Diabltica/AudioInterface/AudioInterface.kicad_pcb

## KiCad design AudioInterface.kicad_pcb (2024-12-24)

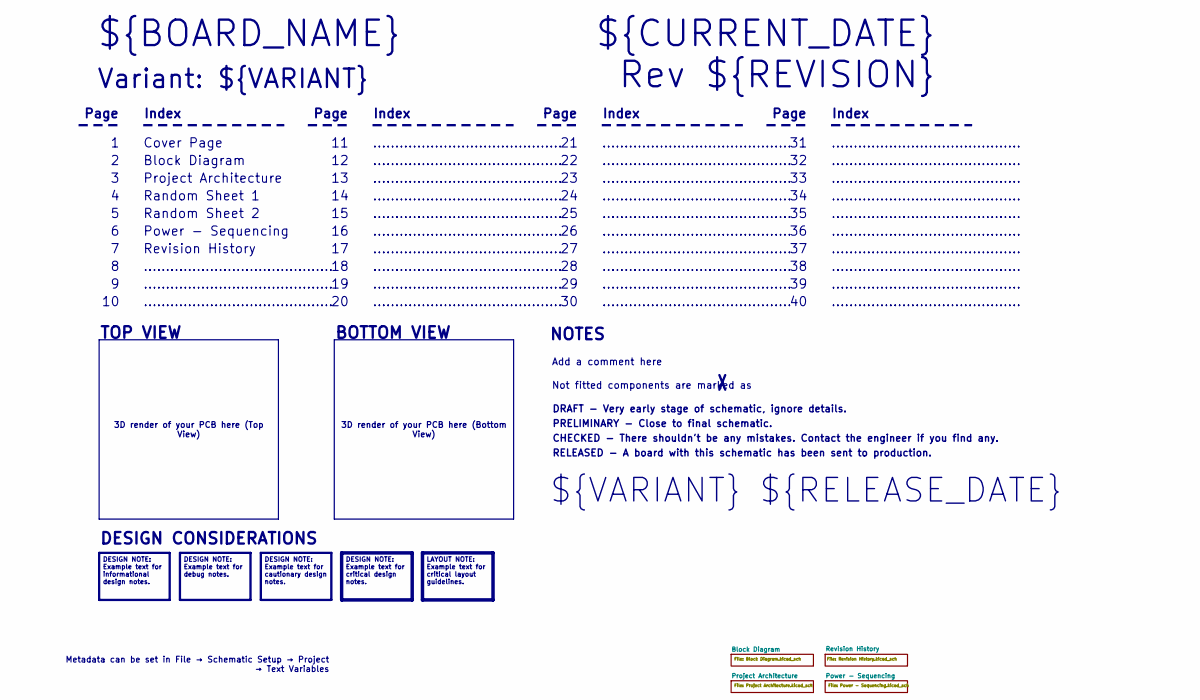
[picture p1: schematic AudioInterface.kicad_sch, Cover Page]

Notes on the sheet:
3D render of your PCB here (Bottom View)
3D render of your PCB here (Top View)
Metadata can be set in File → Schematic Setup → Project → Text Variables
DESIGN NOTE: Example text for informational design notes.
LAYOUT NOTE: Example text for critical layout guidelines.
DESIGN NOTE: Example text for cautionary design notes.
DESIGN NOTE: Example text for debug notes.
DESIGN NOTE: Example text for critical design notes.
BOTTOM VIEW
...........................................
RELEASED - A board with this schematic has been sent to production.
Page
TOP VIEW
Not fitted components are marked as
Index
PRELIMINARY - Close to final schematic.
${VARIANT} ${RELEASE_DATE}
Random Sheet 1
${CURRENT_DATE}
Variant: ${VARIANT}
Rev ${REVISION}
Random Sheet 2
${BOARD_NAME}
DRAFT - Very early stage of schematic, ignore details.
Power - Sequencing
Block Diagram
Add a comment here
Cover Page
NOTES
Project Architecture
CHECKED - There shouldn't be any mistakes. Contact the engineer if you find any.
DESIGN CONSIDERATIONS
Revision History

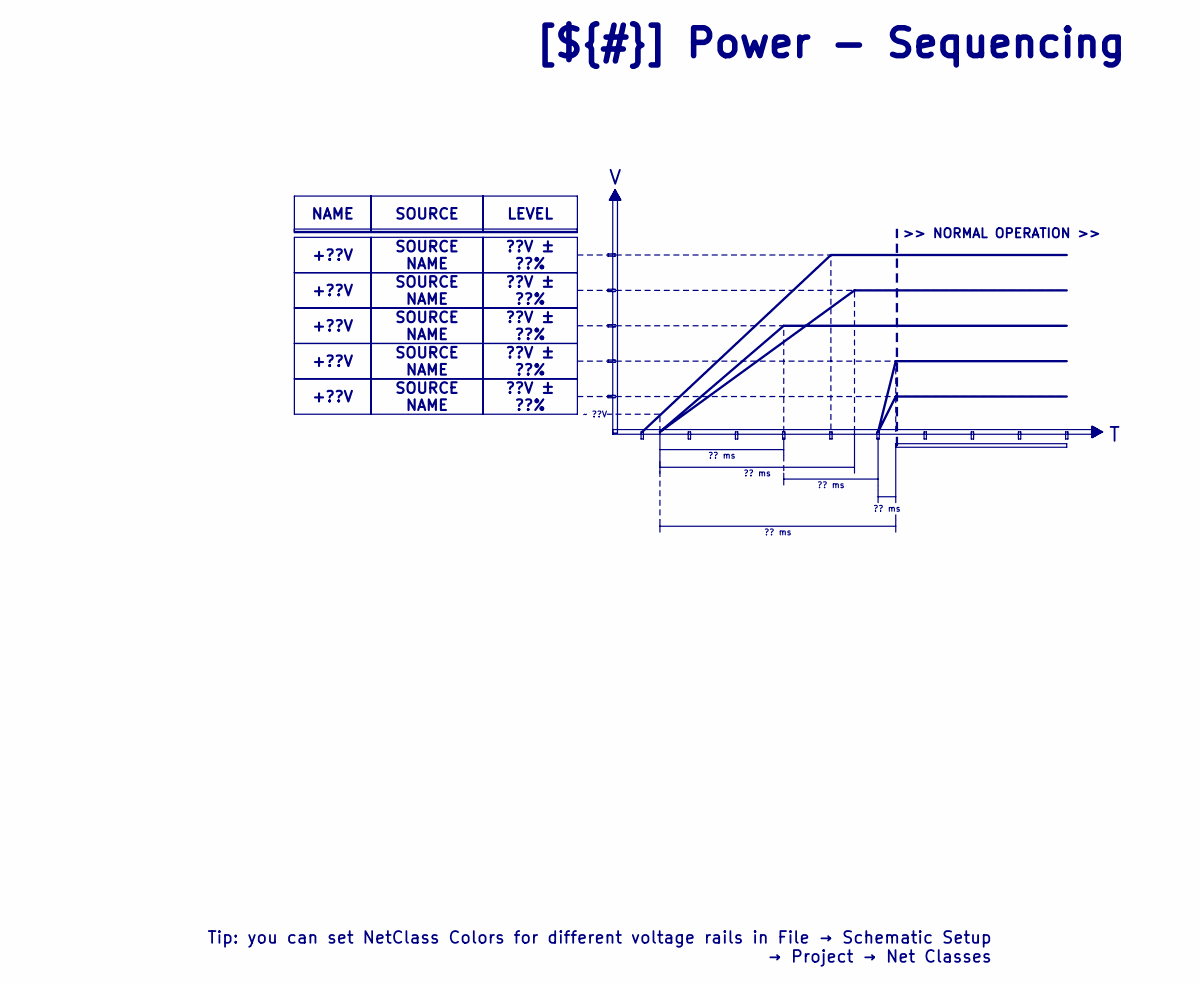
[picture p2: schematic Power - Sequencing.kicad_sch]

Notes on the sheet:
LEVEL
+??V
SOURCE NAME
?? ms
??V ± ??%
[${#}] ${TITLE}
~ ??V
NAME
SOURCE
Tip: you can set NetClass Colors for different voltage rails in File → Schematic Setup → Project → Net Classes
>> NORMAL OPERATION >>

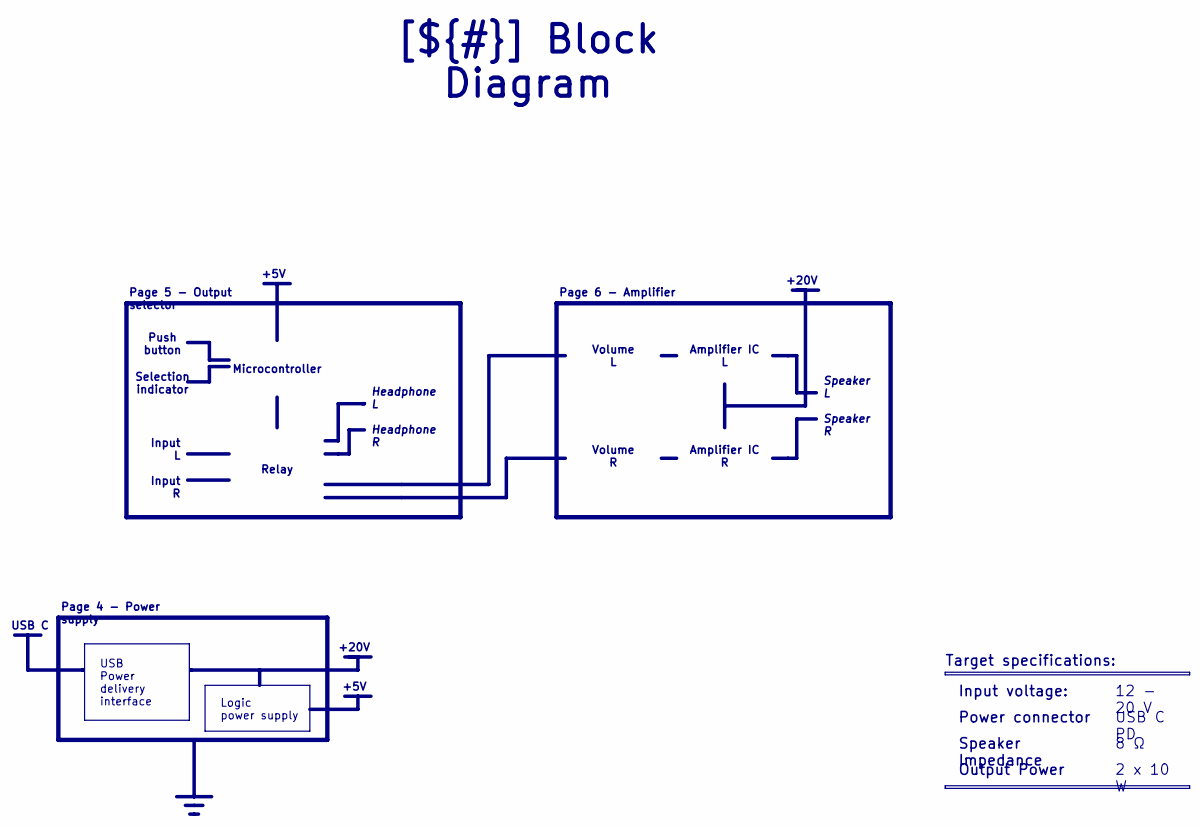
[picture p3: schematic Block Diagram.kicad_sch]

Notes on the sheet:
Page 5 - Output selector
Speaker Impedance
Power connector
Logic power supply
Input voltage:
2 x 10 W
USB C PD
Amplifier IC L
Volume L
Headphone L Headphone R
Microcontroller
[${#}] ${TITLE}
Page 4 - Power supply
Target specifications:
Selection indicator
8 Ω
Page 6 - Amplifier
12 - 20 V
Push button
Amplifier IC R
Relay
Input L Input R
Output Power
USB Power delivery interface
Volume R
Speaker L Speaker R
+20V
+5V
USB C

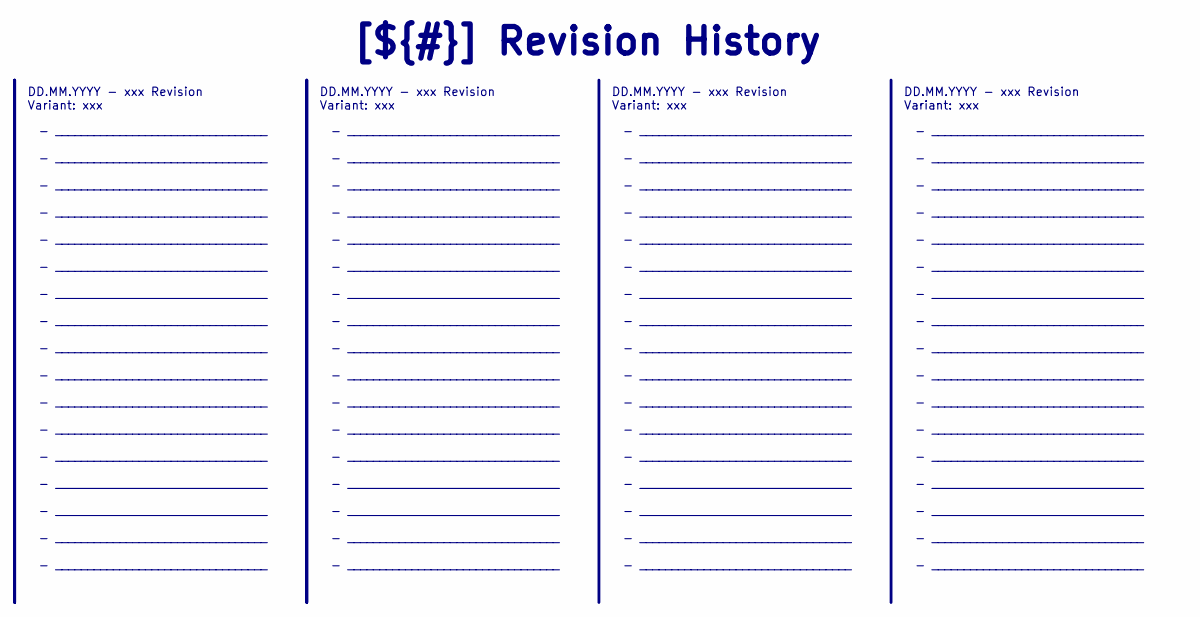
[picture p4: schematic Revision History.kicad_sch]

Notes on the sheet:
- _________________________________ - _________________________________ - _________________________________ - _________________________________ - _________________________________ - _________________________________ - _________________________________ - _________________________________ - _________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
DD.MM.YYYY - xxx Revision Variant: xxx
[${#}] ${TITLE}

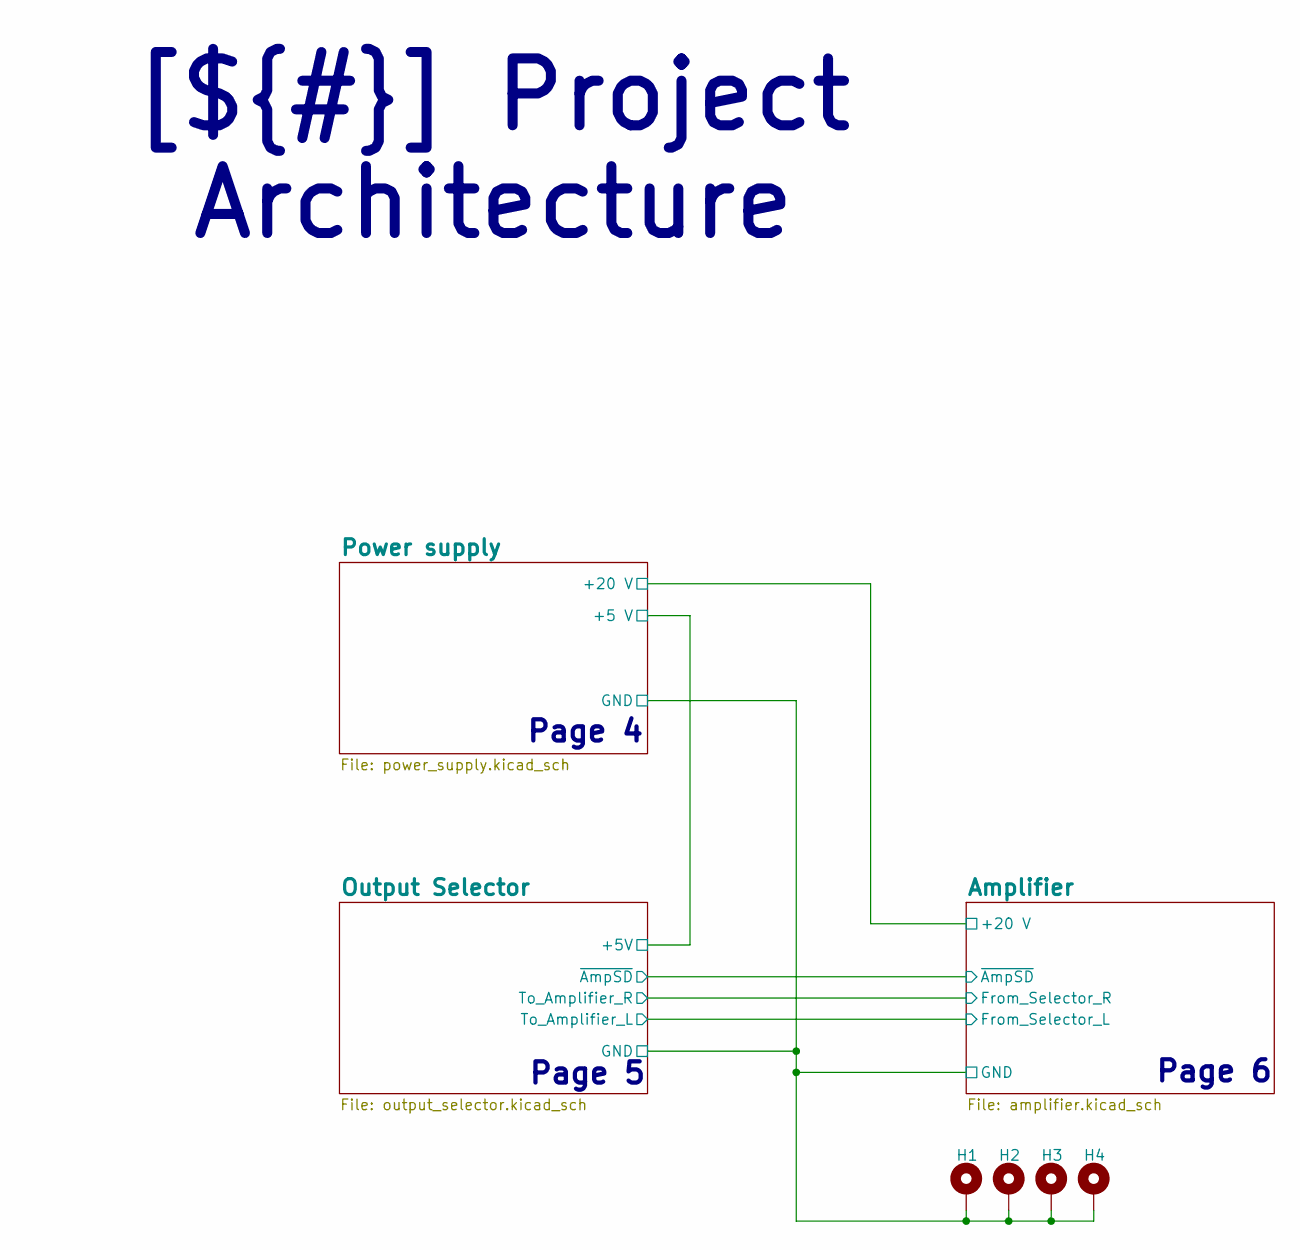
[picture p5: schematic Project Architecture.kicad_sch]

Parts:
H1, H2, H3, H4: MountingHole_Pad; MountingHole_3.2mm_M3_Pad_Via

Connections:
GND: H1.1, H2.1, H3.1, H4.1; also elsewhere on the board

Notes on the sheet:
[${#}] ${TITLE}
Page 6
Page 5
Page 4

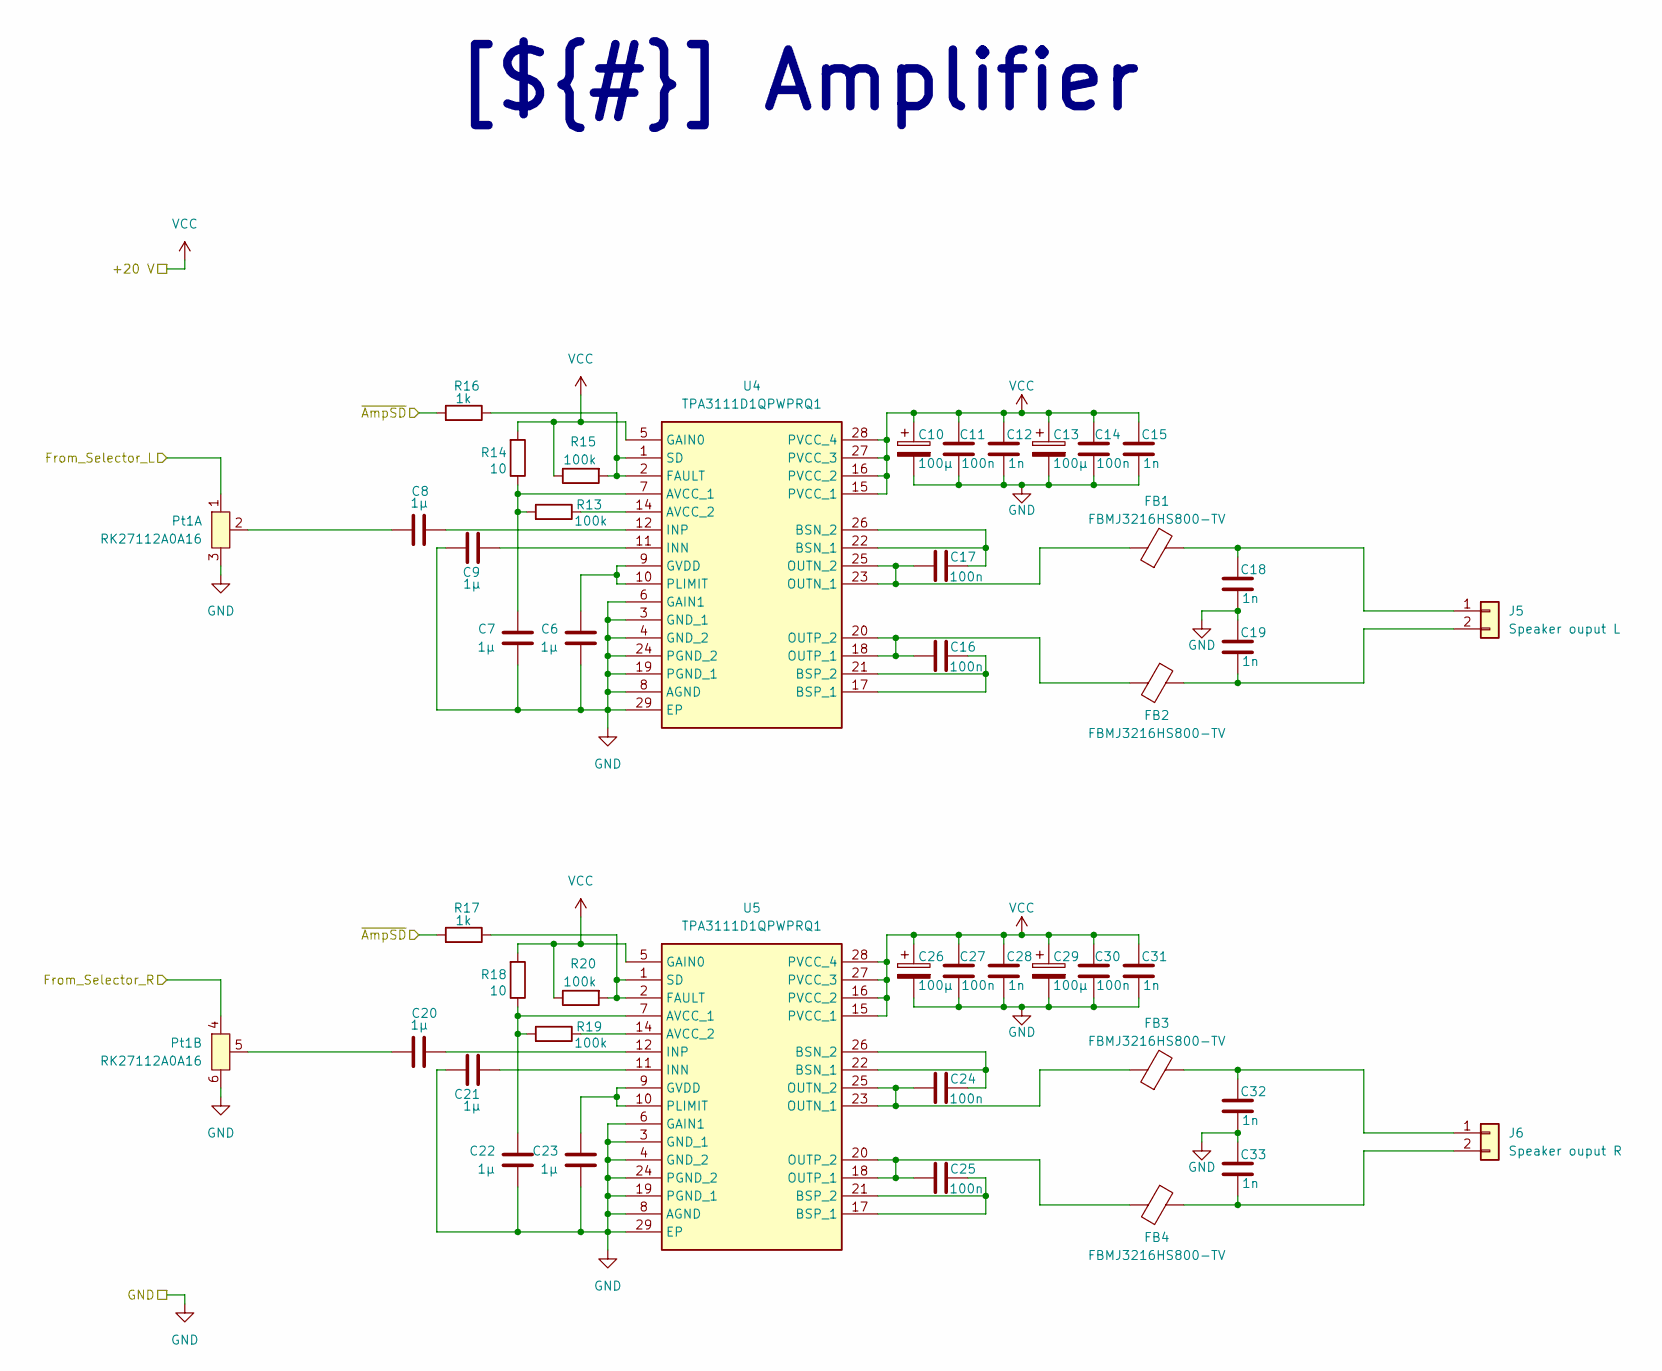
[picture p6: schematic amplifier.kicad_sch]

Parts:
C6, C7, C8, C9, C20, C21, C22, C23: 1µ; C_0402_1005Metric; LCSC Part C1518208
C10, C13, C26, C29: 100µ; CP_Elec_6.3x7.7; LCSC Part C178585
C11, C14, C16, C17, C24, C25, C27, C30: 100n; C_0402_1005Metric; LCSC Part C77020
C12, C15, C18, C19, C28, C31, C32, C33: 1n; C_0402_1005Metric; LCSC Part C77018
FB1, FB2, FB3, FB4: FBMJ3216HS800-TV; L_1206_3216Metric; LCSC C2661525
J5: Speaker ouput L; PinHeader_1x02_P2.54mm_Vertical
J6: Speaker ouput R; PinHeader_1x02_P2.54mm_Vertical
Pt1: RK27112A0A16; RES-ADJ-TH_RK27112A0A16; LCSC Part C470508
R13, R15, R19, R20: 100k; R_0402_1005Metric; LCSC Part C427253
R14, R18: 10; R_0402_1005Metric; LCSC Part C854481
R16, R17: 1k; R_0402_1005Metric; LCSC Part C427241
U4, U5: TPA3111D1QPWPRQ1; SOP65P640X120-29N; Mouser Part Number 595-TPA3111D1QPWPRQ1

Connections:
/Project Architecture/Amplifier/From_Selector_L: Pt1.1; also elsewhere on the board
/Project Architecture/Amplifier/From_Selector_R: Pt1.4; also elsewhere on the board
/Project Architecture/Amplifier/~AmpSD: R16.2, R17.2; also elsewhere on the board
GND: C6.1, C7.1, C9.2, C10.2, C11.1, C12.1, C13.2, C14.1, C15.1, C18.1, C19.2, C21.2, C22.1, C23.1, C26.2, C27.1, C28.1, C29.2, C30.1, C31.1, C32.1, C33.2, Pt1.3, Pt1.6, U4.3 (GND_1), U4.4 (GND_2), U4.6 (GAIN1), U4.8 (AGND), U4.19 (PGND_1), U4.24 (PGND_2), U4.29 (EP), U5.3 (GND_1), U5.4 (GND_2), U5.6 (GAIN1), U5.8 (AGND), U5.19 (PGND_1), U5.24 (PGND_2), U5.29 (EP); also elsewhere on the board
unnamed: C8.1, Pt1.2
unnamed: C20.1, Pt1.5
unnamed: C18.2, FB1.2, J5.1
unnamed: C19.1, FB2.1, J5.2
unnamed: C32.2, FB3.2, J6.1
unnamed: C33.1, FB4.1, J6.2
unnamed: C7.2, R13.2, R14.1, U4.7 (AVCC_1)
unnamed: R13.1, U4.14 (AVCC_2)
unnamed: C17.1, U4.22 (BSN_1), U4.26 (BSN_2)
unnamed: C16.1, U4.17 (BSP_1), U4.21 (BSP_2)
unnamed: R15.2, R16.1, U4.1 (SD), U4.2 (FAULT)
unnamed: C6.2, U4.9 (GVDD), U4.10 (PLIMIT)
unnamed: C9.1, U4.11 (INN)
unnamed: C8.2, U4.12 (INP)
unnamed: C17.2, FB1.1, U4.23 (OUTN_1), U4.25 (OUTN_2)
unnamed: C16.2, FB2.2, U4.18 (OUTP_1), U4.20 (OUTP_2)
unnamed: C22.2, R18.1, R19.2, U5.7 (AVCC_1)
unnamed: R19.1, U5.14 (AVCC_2)
unnamed: C24.1, U5.22 (BSN_1), U5.26 (BSN_2)
unnamed: C25.1, U5.17 (BSP_1), U5.21 (BSP_2)
unnamed: R17.1, R20.2, U5.1 (SD), U5.2 (FAULT)
unnamed: C23.2, U5.9 (GVDD), U5.10 (PLIMIT)
unnamed: C21.1, U5.11 (INN)
unnamed: C20.2, U5.12 (INP)
unnamed: C24.2, FB3.1, U5.23 (OUTN_1), U5.25 (OUTN_2)
unnamed: C25.2, FB4.2, U5.18 (OUTP_1), U5.20 (OUTP_2)
VCC: C10.1, C11.2, C12.2, C13.1, C14.2, C15.2, C26.1, C27.2, C28.2, C29.1, C30.2, C31.2, R14.2, R15.1, R18.2, R20.1, U4.5 (GAIN0), U4.15 (PVCC_1), U4.16 (PVCC_2), U4.27 (PVCC_3), U4.28 (PVCC_4), U5.5 (GAIN0), U5.15 (PVCC_1), U5.16 (PVCC_2), U5.27 (PVCC_3), U5.28 (PVCC_4); also elsewhere on the board

Notes on the sheet:
[${#}] ${TITLE}

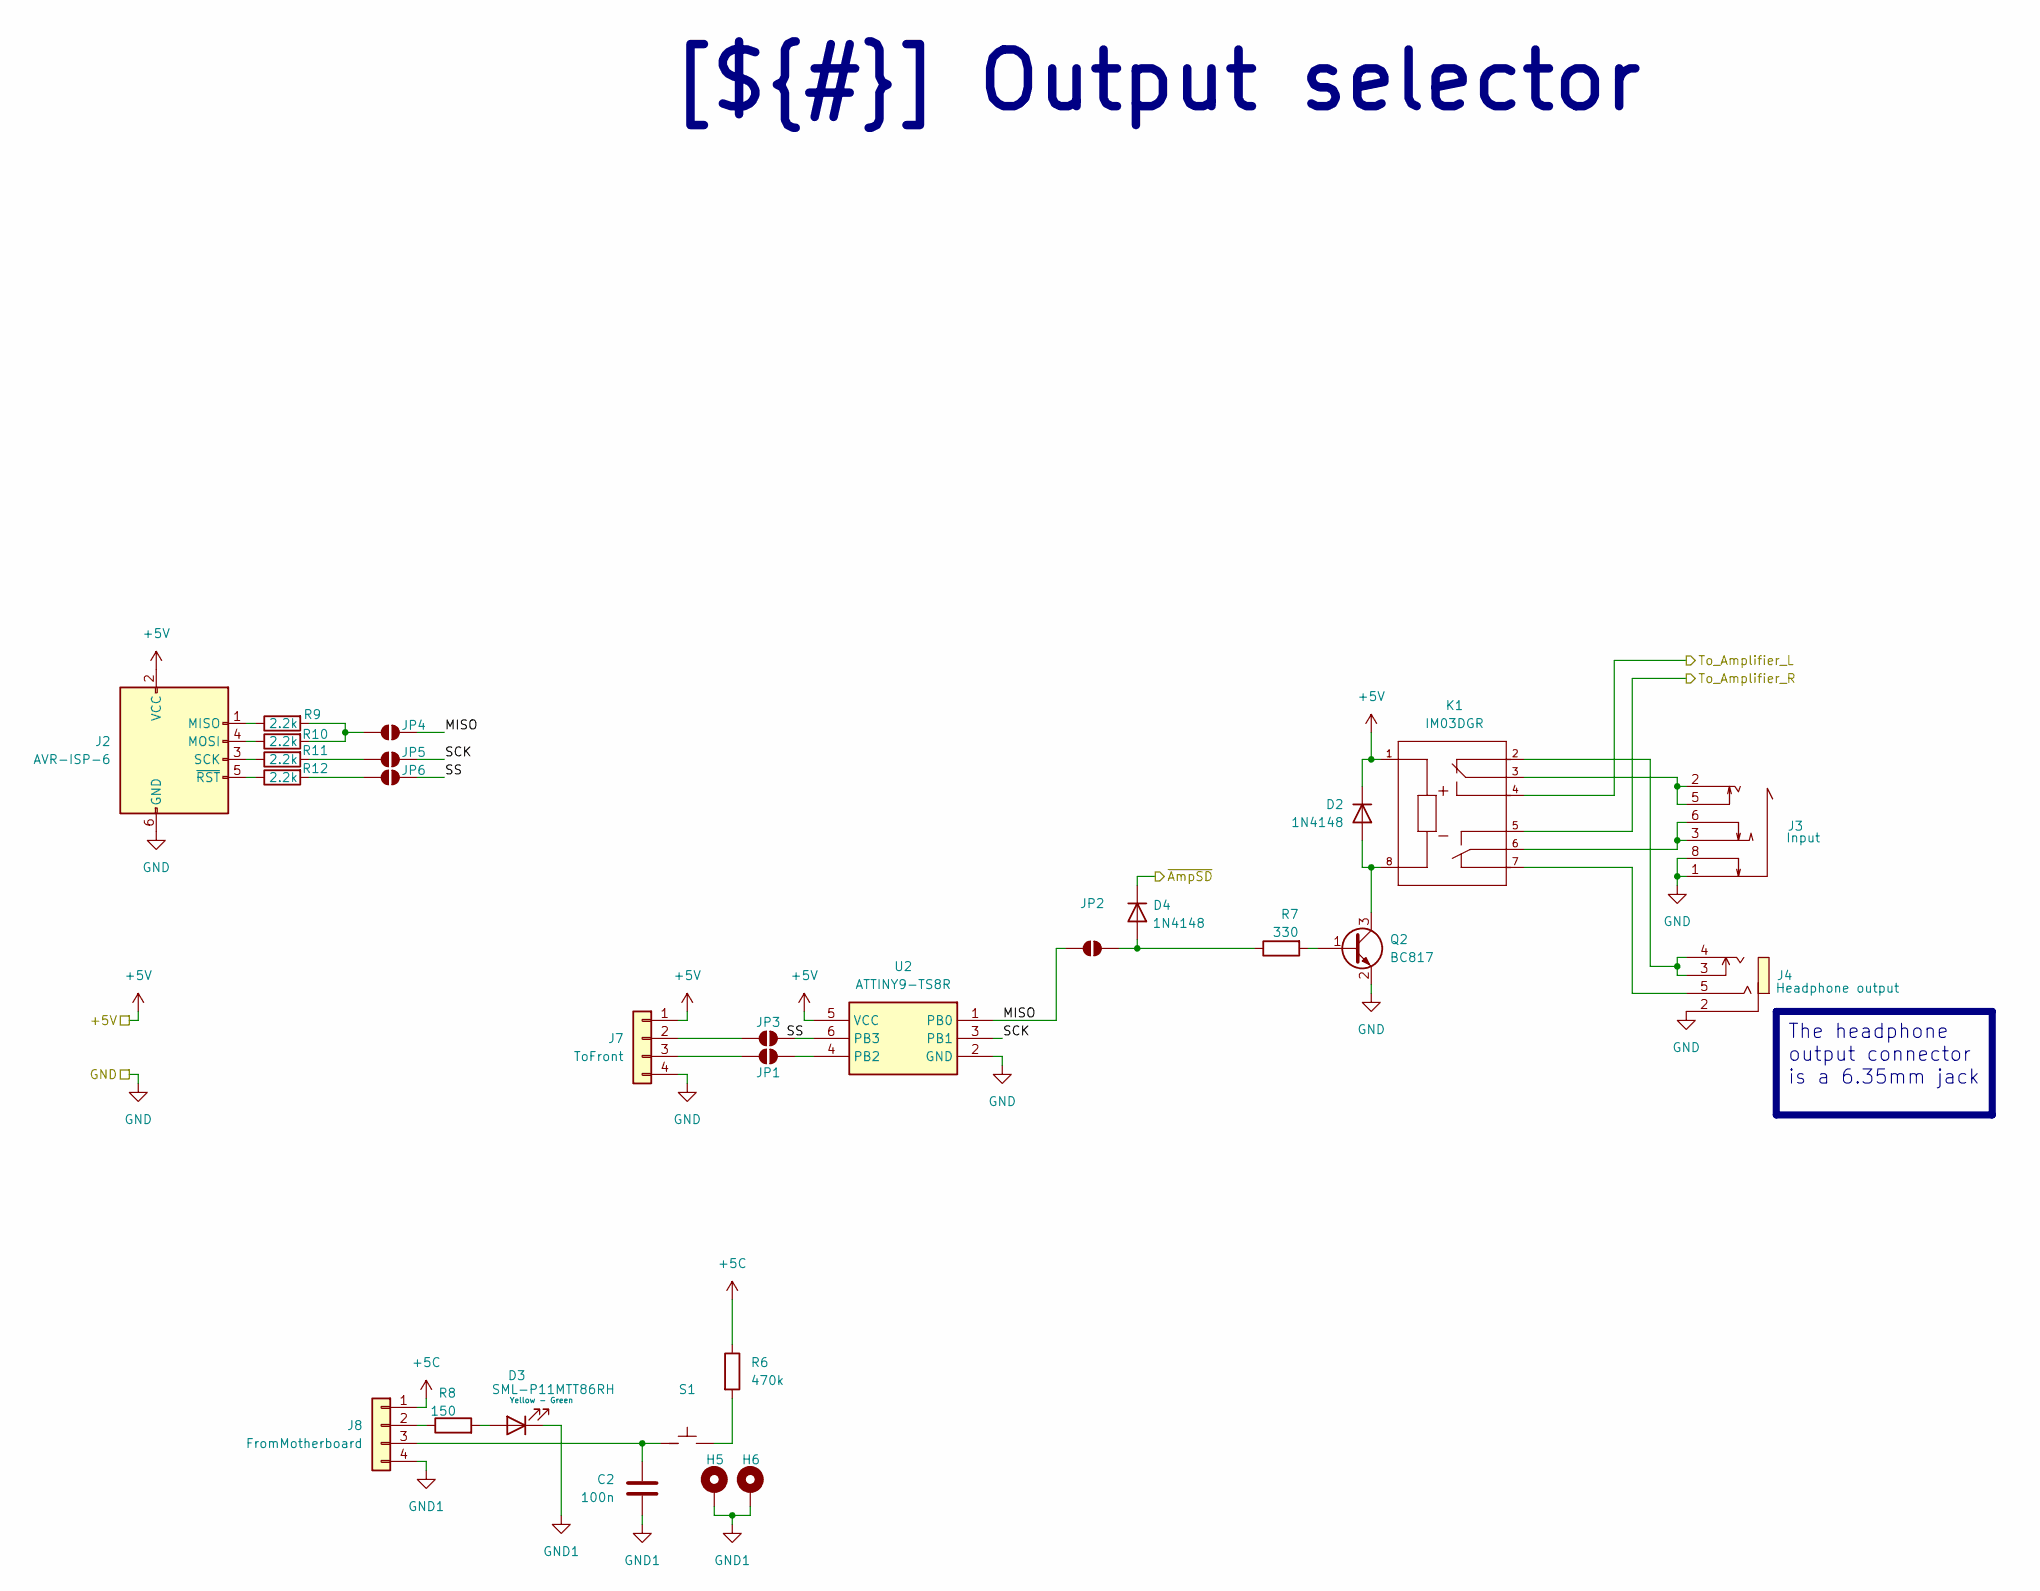
[picture p7: schematic output_selector.kicad_sch, Output selector]

Parts:
C2: 100n; C_0402_1005Metric; LCSC Part C77020
D2, D4: 1N4148; D_SOD-123; LCSC Part C5805632
D3: SML-P11MTT86RH; LED_0402_1005Metric; LCSC part C2898986
H5, H6: MountingHole_Pad; MountingHole_3.2mm_M3_Pad_Via
J2: AVR-ISP-6; PinSocket_2x03_P2.54mm_Vertical
J3: PJ-393-8P; AUDIO-TH_PJ-393-8A; LCSC Part C5155561
J4: PJ-603; AUDIO-TH_PJ-603; LCSC Part C309272
J7: ToFront; PinHeader_1x04_P2.54mm_Vertical
J8: FromMotherboard; PinHeader_1x04_P2.54mm_Vertical
JP1, JP2, JP3, JP4, JP5, JP6: SolderJumper_2_Open; SolderJumper-2_P1.3mm_Open_TrianglePad1.0x1.5mm
K1: IM03DGR; RELAY_IM03DGR; LCSC Part C5439567
Q2: BC817; SOT-23; LCSC Part C52801
R6: 470k; R_0402_1005Metric; LCSC Part C427256
R7: 330; R_0402_1005Metric; LCSC Part C427206
R8: 150; R_0402_1005Metric; LCSC Part C413067
R9, R10, R11, R12: 2.2k; R_0402_1005Metric; LCSC Part C427211
S1: PG151101S11; Kailh_socket_MX; PARTREV A; LCSC Part C41430893
U2: ATTINY9-TS8R; SOT95P270X145-6N; Mouser Part Number 556-ATTINY9-TS8R

Connections:
+5C: J8.1, R6.1
+5V: D2.1 (K), J2.2 (VCC), J7.1, K1.1, U2.5 (VCC); also elsewhere on the board
/Project Architecture/Amplifier/From_Selector_L: K1.4; also elsewhere on the board
/Project Architecture/Amplifier/From_Selector_R: K1.5; also elsewhere on the board
/Project Architecture/Amplifier/~AmpSD: D4.1 (K); also elsewhere on the board
/Project Architecture/Output Selector/MISO: JP2.1 (A), JP4.2 (B), U2.1 (PB0)
/Project Architecture/Output Selector/SCK: JP5.2 (B), U2.3 (PB1)
/Project Architecture/Output Selector/SS: JP3.1 (A), JP6.2 (B), U2.6 (PB3)
GND: J2.6 (GND), J3.1, J3.8, J4.2, J7.4, Q2.2 (E), U2.2 (GND); also elsewhere on the board
GND1: C2.1, D3.1 (K), H5.1, H6.1, J8.4
unnamed: D2.2 (A), K1.8, Q2.3 (C)
unnamed: D3.2 (A), R8.2
unnamed: D4.2 (A), JP2.2 (B), R7.1
unnamed: J2.1 (MISO), R9.1
unnamed: J2.4 (MOSI), R10.1
unnamed: J2.3 (SCK), R11.1
unnamed: J2.5 (~RST), R12.1
unnamed: J3.2, J3.5, K1.3
unnamed: J3.3, J3.6, K1.6
unnamed: J4.3, J4.4, K1.2
unnamed: J4.5, K1.7
unnamed: J7.2, JP3.2 (B)
unnamed: J7.3, JP1.1 (A)
unnamed: J8.2, R8.1
unnamed: C2.2, J8.3, S1.2
unnamed: JP1.2 (B), U2.4 (PB2)
unnamed: JP4.1 (A), R9.2, R10.2
unnamed: JP5.1 (A), R11.2
unnamed: JP6.1 (A), R12.2
unnamed: Q2.1 (B), R7.2
unnamed: R6.2, S1.1

Notes on the sheet:
[${#}] ${TITLE}
The headphone output connector is a 6.35mm jack

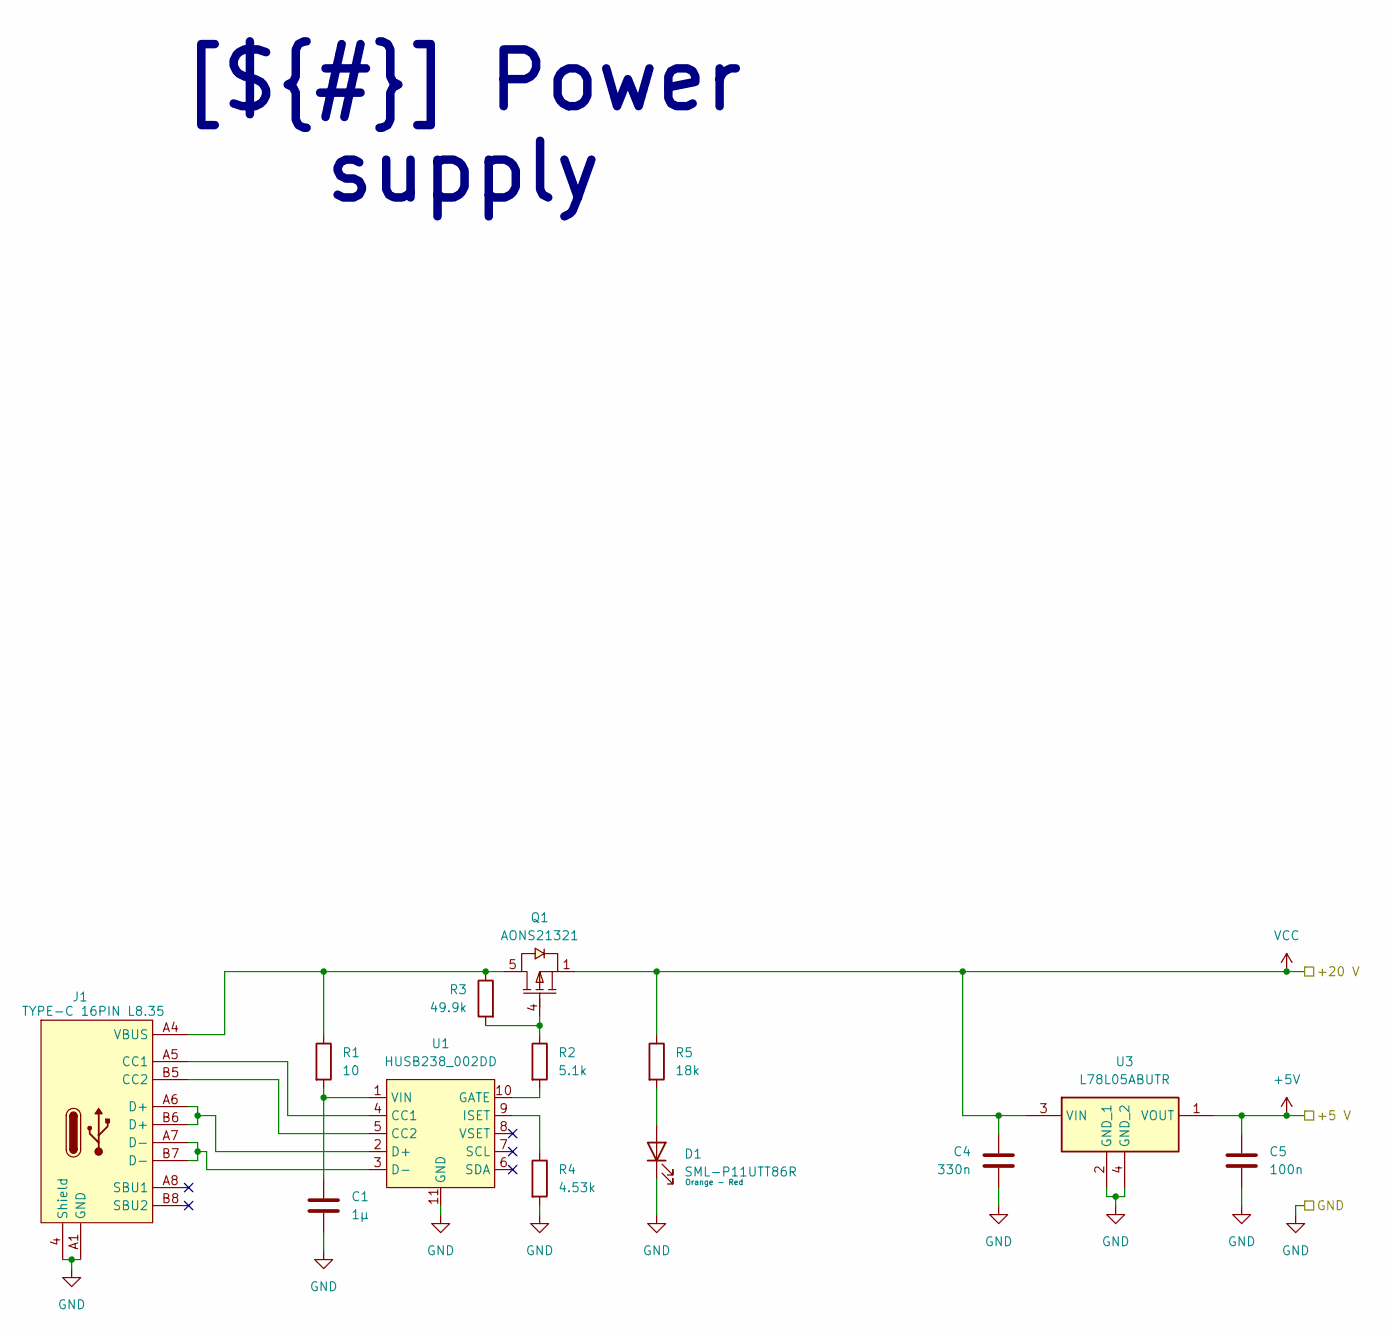
[picture p8: schematic power_supply.kicad_sch, Power supply]

Parts:
C1: 1µ; C_0402_1005Metric; LCSC Part C1518208
C4: 330n; C_0402_1005Metric; LCSC Part C16193239
C5: 100n; C_0402_1005Metric; LCSC Part C77020
D1: SML-P11UTT86R; LED_0402_1005Metric; LCSC part C510300
J1: TYPE-C 16PIN L8.35; TYPE-C-SMD_20009-UCAF001-X; LCSC Part C5379909
Q1: AONS21321; DFN-8_L6.0-W5.0-P1.27-LS6.2-BL; LCSC Part C5143571
R1: 10; R_0402_1005Metric; LCSC Part C854481
R2: 5.1k; R_0603_1608Metric; LCSC Part C413696
R3: 49.9k; R_0402_1005Metric; LCSC Part C409918
R4: 4.53k; R_0402_1005Metric; LCSC Part C416543
R5: 18k; R_0402_1005Metric; LCSC Part C413008
U1: HUSB238_002DD; DFN-10_L3.0-W3.0-P0.50-BL-EP2.5; LCSC Part C7471904
U3: L78L05ABUTR; Mouser Part Number 511-L78L05ABU

Connections:
+5V: C5.2, U3.1 (VOUT); also elsewhere on the board
GND: C1.1, C4.1, C5.1, D1.1 (K), J1.4 (Shield), J1.A1 (GND), R4.2, U1.11 (GND), U3.2 (GND_1), U3.4 (GND_2); also elsewhere on the board
unnamed: D1.2 (A), R5.2
unnamed: J1.A5 (CC1), U1.4 (CC1)
unnamed: J1.B5 (CC2), U1.5 (CC2)
unnamed: J1.A4 (VBUS), Q1.5 (D), R1.1, R3.1
unnamed: Q1.4 (G), R2.1, R3.2
unnamed: J1.A6 (D+), J1.B6 (D+), U1.2 (D+)
unnamed: J1.A7 (D-), J1.B7 (D-), U1.3 (D-)
unnamed: R2.2, U1.10 (GATE)
unnamed: R4.1, U1.9 (ISET)
unnamed: C1.2, R1.2, U1.1 (VIN)
VCC: C4.2, Q1.1 (S), R5.1, U3.3 (VIN); also elsewhere on the board

Notes on the sheet:
[${#}] ${TITLE}

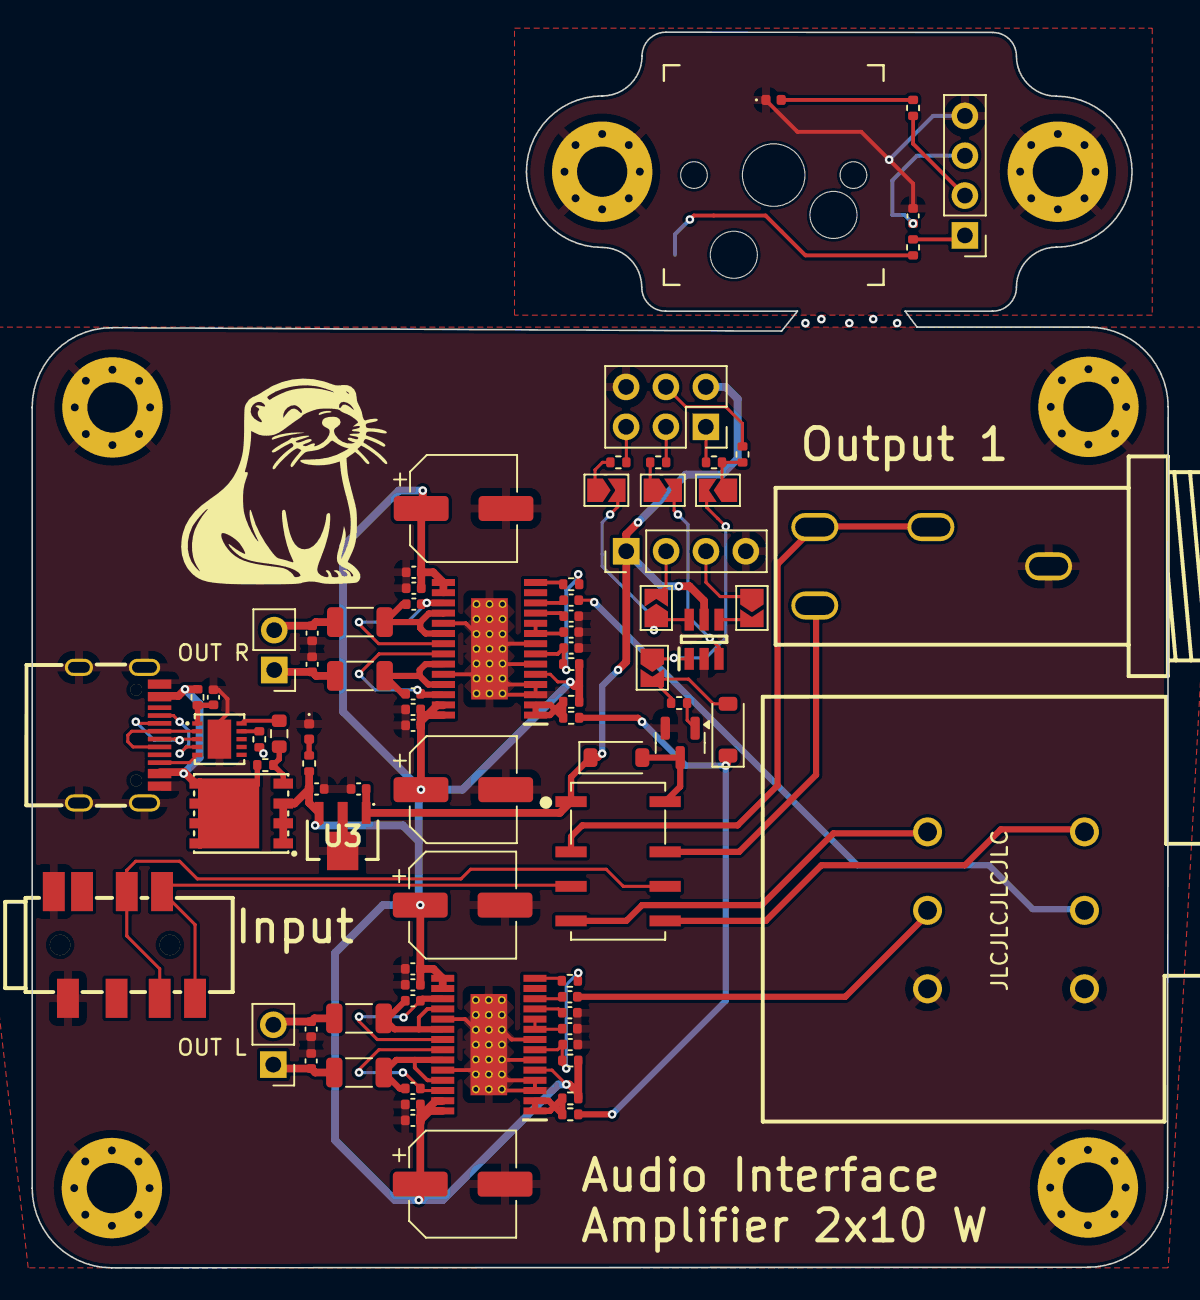
[picture p9: board AudioInterface.kicad_pcb from above]

Board: 2 copper layers, 72.4 x 78.7 mm, 90 parts (0 on the bottom side), 68 nets.
