Diabltica/AudioInterface/(commit log)

2024-12-21 power supply first draft
    [AudioInterface.kicad_pcb, Project Architecture.kicad_sch, amplifier.kicad_sch, output_selector.kicad_sch, power_supply.kicad_sch]
2024-12-21 Add output selector
    [Project Architecture.kicad_sch, output_selector.kicad_sch, power_supply.kicad_sch]
2024-12-21 add 5V regulator
    [Project Architecture.kicad_sch, power_supply.kicad_sch]
2024-12-22 update config to export schematic documentation
2024-12-22 place component on pcb to generate bom
    [AudioInterface.kicad_pcb, power_supply.kicad_sch]
2024-12-22 draft amplifier circuit
    [amplifier.kicad_sch, output_selector.kicad_sch]
2024-12-23 Finish amplifier, add shutdown control
    [amplifier.kicad_sch, output_selector.kicad_sch]
2024-12-23 change C10, C13, C24, C29 to polarized capacitor
    [amplifier.kicad_sch]
2024-12-23 complete wiring
    [Project Architecture.kicad_sch]
2024-12-23 source component and fix some lib
    [AudioInterface.kicad_pcb, amplifier.kicad_sch, output_selector.kicad_sch, power_supply.kicad_sch]
2024-12-24 add connector to separate the selector switch and led indicator
    [AudioInterface.kicad_pcb, amplifier.kicad_sch, output_selector.kicad_sch]
2024-12-24 update footprint
2024-12-24 finish pcb and generate production file
    [AudioInterface-CuBottom.gbr, AudioInterface-CuTop.gbr, AudioInterface-EdgeCuts.gbr, AudioInterface-MaskBottom.gbr, AudioInterface-MaskTop.gbr, AudioInterface-NPTH.drl, AudioInterface-PTH.drl, AudioInterface-PasteBottom.gbr]
